lagovsp/eac-cp-huffman-encoder/(list of files, drawings)

Other design files:
blocks/diodes-net.pdsprj
blocks/huffman-code.pdsprj
blocks/huffman-full.pdsprj
blocks/huffman-sort-end.pdsprj
blocks/huffman-sort-start.pdsprj
blocks/huffman-tree.pdsprj
functional.spl7
huffman-coder-backup1.pdsprj
huffman-coder-backup.pdsprj
huffman-coder.pdsprj
huffman-encoding.pdsprj
huffman-tree.pdsprj
test-sort-2.pdsprj
test-sort-end.pdsprj
test-tree.pdsprj
test.pdsprj
